nickpascucci/Robot-Arm/mechanical/AX_12_Drawing.jpg

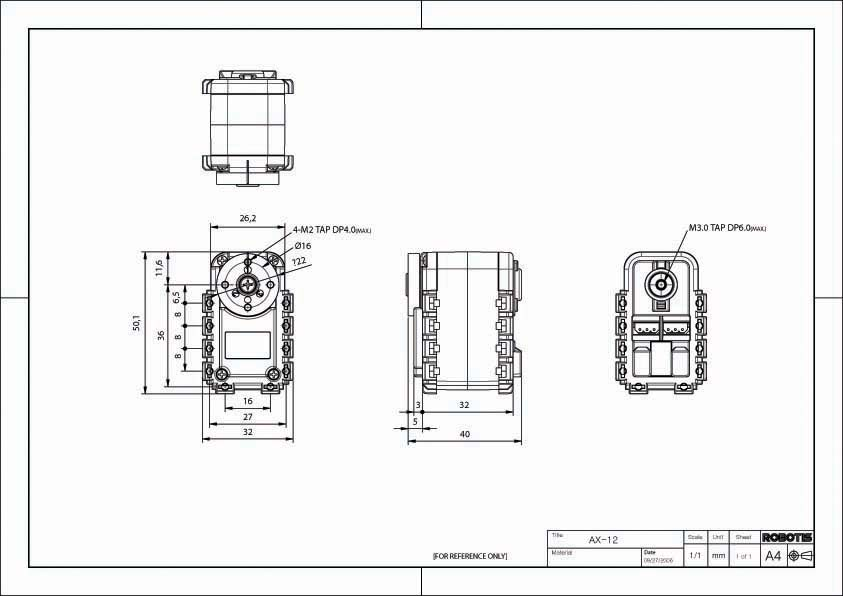
mechanical/AX_12_Drawing.jpg
