nickpascucci/Robot-Arm/mechanical/Costs.ods

Robot Arm Costs
Component | Unit Cost | Quantity | Total | Grand Total
1' 1.125” Delrin Rod | $30.14 | 2 | $60.28 | $690.88
1.5 | $26.93 | 2 | $53.86
AX-12 | $44.90 | 3 | $134.70
Hitec HS-485HB Standard Servo | $19.99 | 3 | $59.97
24” x 24” x .04” Aluminum Sheet | $36.64 | 2 | $73.28
Electronics | $200.00 | 1 | $200.00
Ball Bearing | $8.79 | 1 | $8.79
Spare Parts / Unforeseen Circumstances | $100.00 | 1 | $100.00
