nickpascucci/Robot-Arm/mechanical/EP_Proximal.dxf

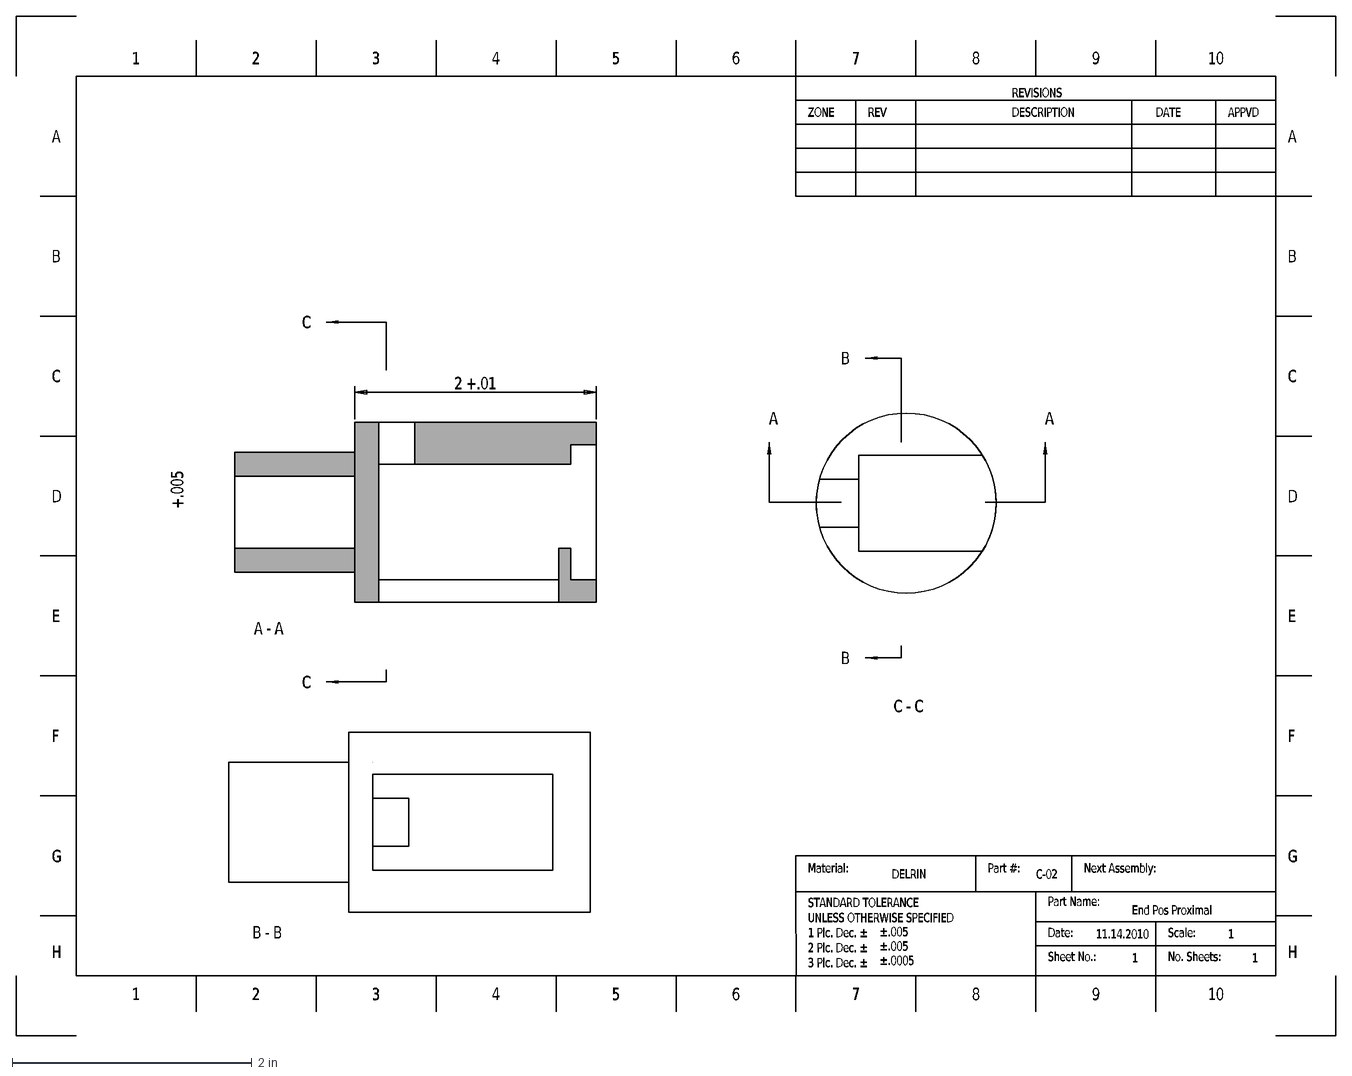
[picture p2: CAD file, 2011-05-08]
mechanical/EP_Proximal.dxf
1
2
3
4
5
6
7
8
9
10
A
B
C
D
E
F
G
H
STANDARD\~TOLERANCE UNLESS\~OTHERWISE\~SPECIFIED 1\~Plc.\~Dec.\~±\~ 2\~Plc.\~Dec.\~±\~ 3\~Plc.\~Dec.\~±
Material:
Part\~#:
Next\~Assembly:
Part\~Name:
Date:
Scale:
Sheet\~No.:
No.\~Sheets:
REVISIONS
ZONE
REV
DESCRIPTION
DATE
APPVD
DELRIN
C-02
±.005
±.0005
11.14.2010
End\~Pos\~Proximal
+.005
2\~+.01
A\~-\~A
B\~-\~B
C\~-\~C
