nickpascucci/Robot-Arm/mechanical/EP_Mid_Distal.dxf

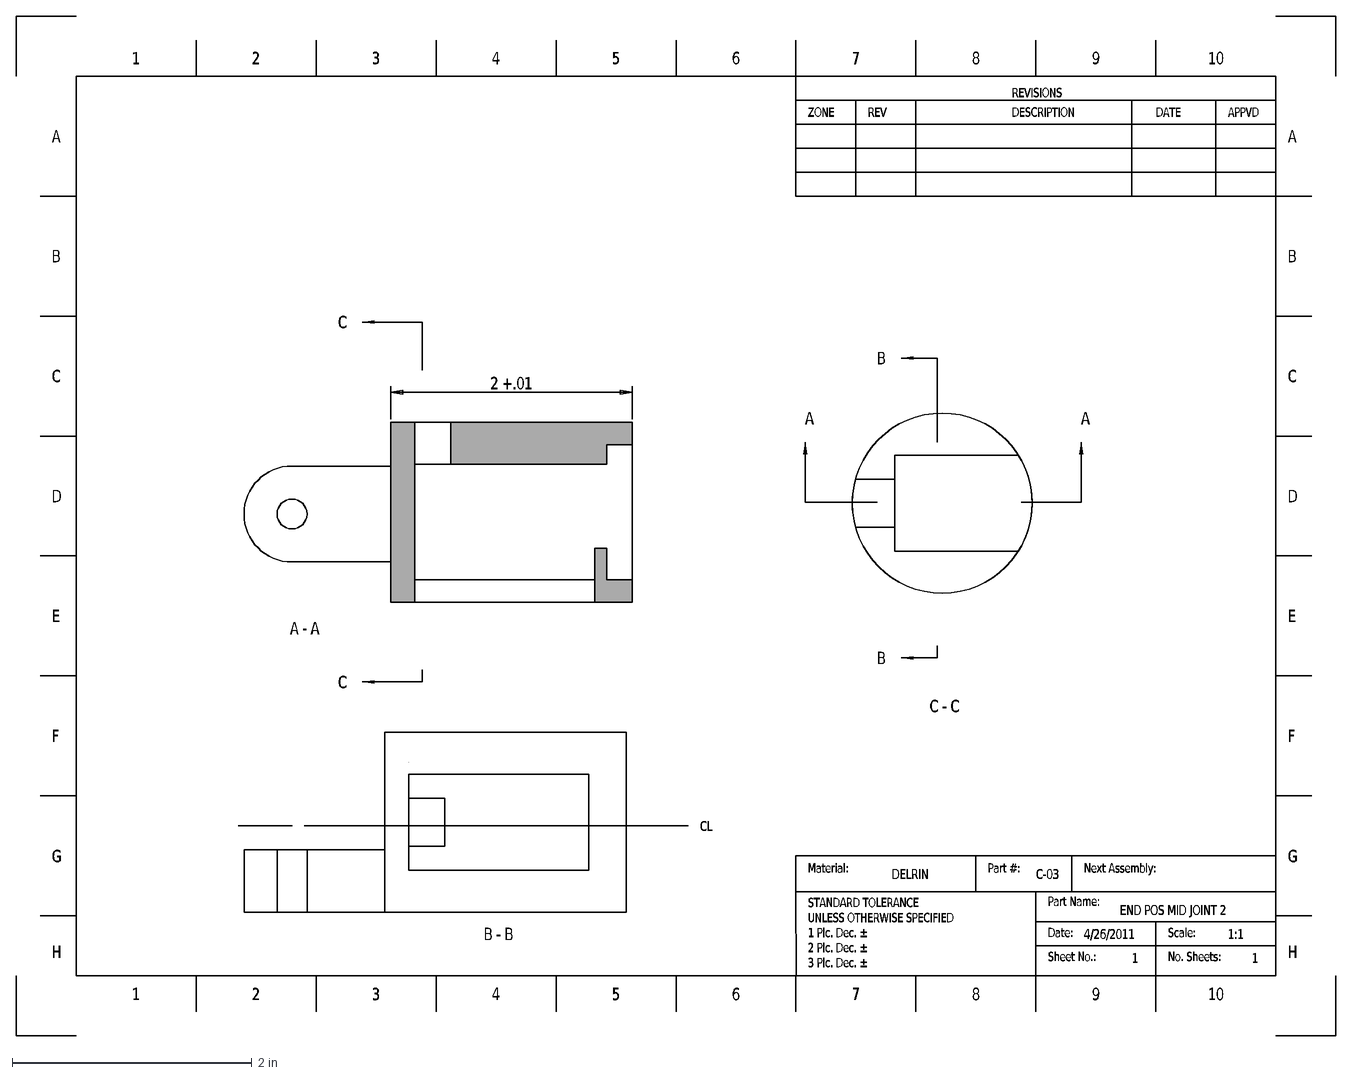
[picture p3: CAD file, 2011-05-08]
mechanical/EP_Mid_Distal.dxf
1
2
3
4
5
6
7
8
9
10
A
B
C
D
E
F
G
H
STANDARD\~TOLERANCE UNLESS\~OTHERWISE\~SPECIFIED 1\~Plc.\~Dec.\~±\~ 2\~Plc.\~Dec.\~±\~ 3\~Plc.\~Dec.\~±
Material:
Part\~#:
Next\~Assembly:
Part\~Name:
Date:
Scale:
Sheet\~No.:
No.\~Sheets:
REVISIONS
ZONE
REV
DESCRIPTION
DATE
APPVD
DELRIN
C-03
END\~POS\~MID\~JOINT\~2
1:1
4/26/2011
2\~+.01
C\~-\~C
B\~-\~B
A\~-\~A
CL
