nickpascucci/Robot-Arm/mechanical/EP_Mid_Proximal.dxf

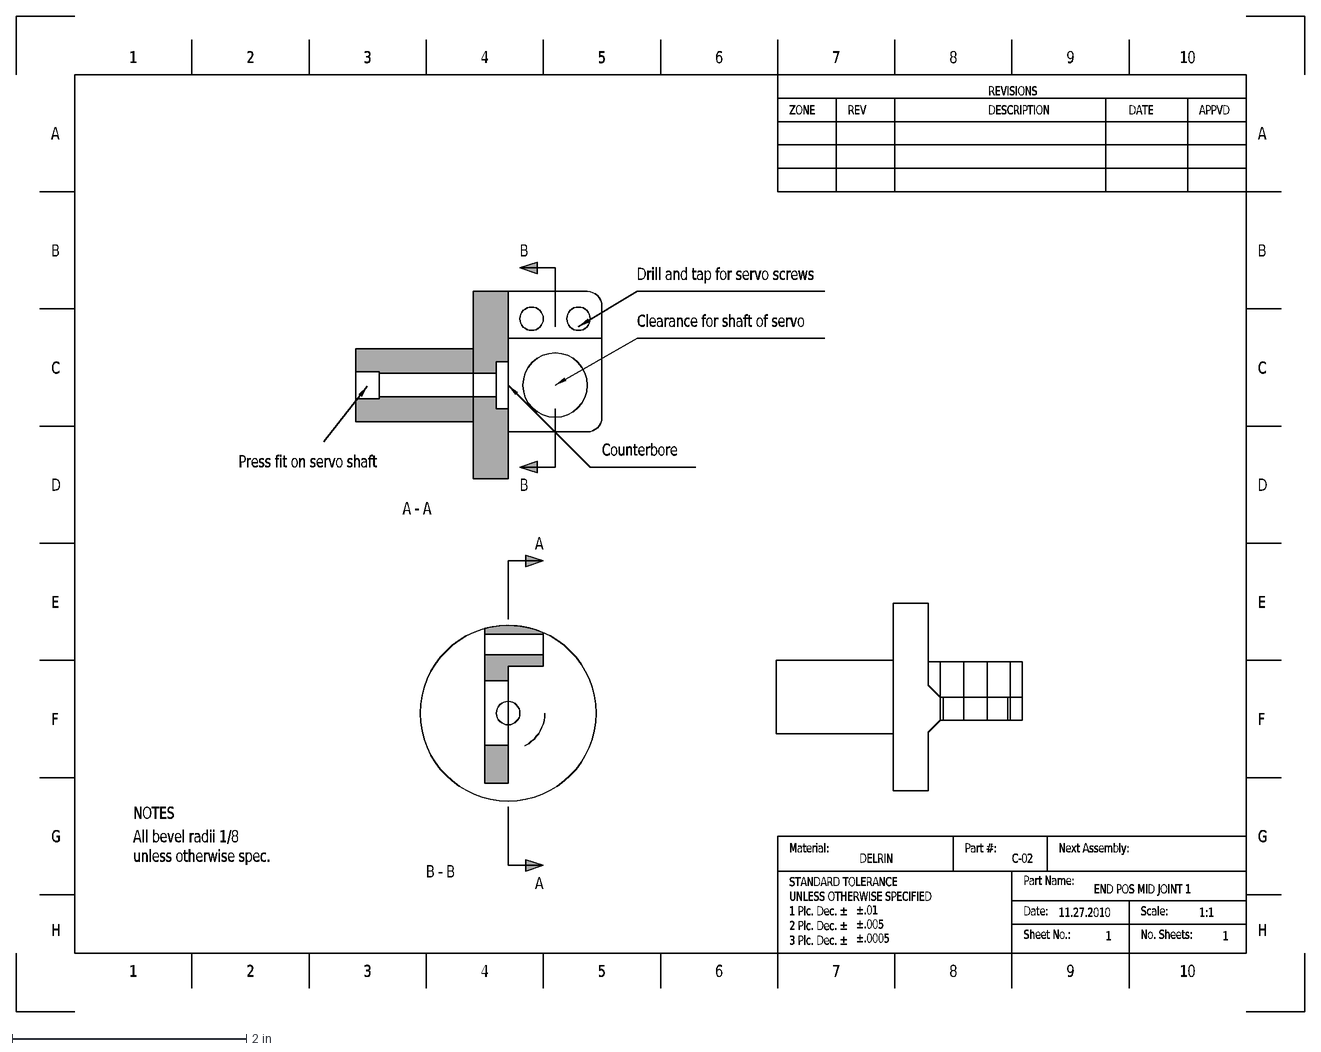
[picture p4: CAD file, 2011-05-08]
mechanical/EP_Mid_Proximal.dxf
Press\~fit\~on\~servo\~shaft
Drill\~and\~tap\~for\~servo\~screws
B
A
A\~-\~A
B\~-\~B
END\~POS\~MID\~JOINT\~1
DELRIN
C-02
11.27.2010
1
1:1
NOTES
All\~bevel\~radii\~1/8 unless\~otherwise\~spec.
Clearance\~for\~shaft\~of\~servo
±.01
±.005
±.0005
2
3
4
5
6
7
8
9
10
C
D
E
F
G
H
STANDARD\~TOLERANCE UNLESS\~OTHERWISE\~SPECIFIED 1\~Plc.\~Dec.\~±\~ 2\~Plc.\~Dec.\~±\~ 3\~Plc.\~Dec.\~±
Material:
Part\~#:
Next\~Assembly:
Part\~Name:
Date:
Scale:
Sheet\~No.:
No.\~Sheets:
REVISIONS
ZONE
REV
DESCRIPTION
DATE
APPVD
Counterbore
