nickpascucci/Robot-Arm/mechanical/Base_Servo_Mount.dxf

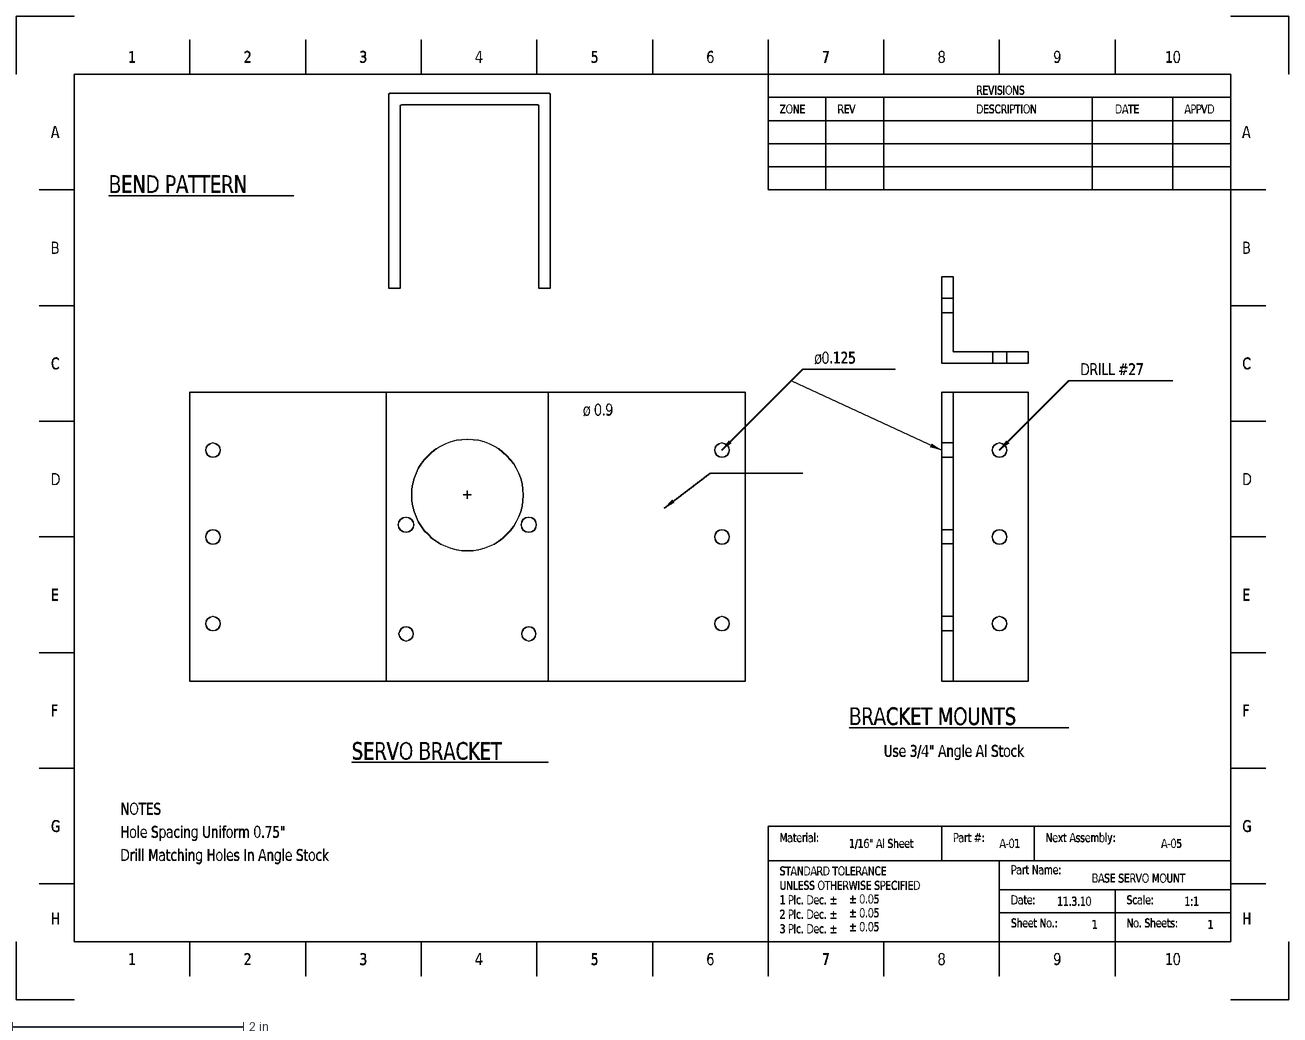
[picture p5: CAD file, 2011-04-27]
mechanical/Base_Servo_Mount.dxf
1
2
3
4
5
6
7
8
9
10
A
B
C
D
E
F
G
H
STANDARD\~TOLERANCE UNLESS\~OTHERWISE\~SPECIFIED 1\~Plc.\~Dec.\~±\~ 2\~Plc.\~Dec.\~±\~ 3\~Plc.\~Dec.\~±
Material:
Part\~#:
Next\~Assembly:
Part\~Name:
Date:
Scale:
Sheet\~No.:
No.\~Sheets:
REVISIONS
ZONE
REV
DESCRIPTION
DATE
APPVD
BASE\~SERVO\~MOUNT
A-05
A-01
1/16"\~Al\~Sheet
11.3.10
1:1
±\~0.05
ø\~0.9
Use\~3/4"\~Angle\~Al\~Stock
Drill\~Matching\~Holes\~In\~Angle\~Stock
Hole\~Spacing\~Uniform\~0.75"
NOTES
ø0.125
DRILL\~#27
SERVO\~BRACKET
BEND\~PATTERN
BRACKET\~MOUNTS
