nickpascucci/Robot-Arm/mechanical/ArmMounts.dxf

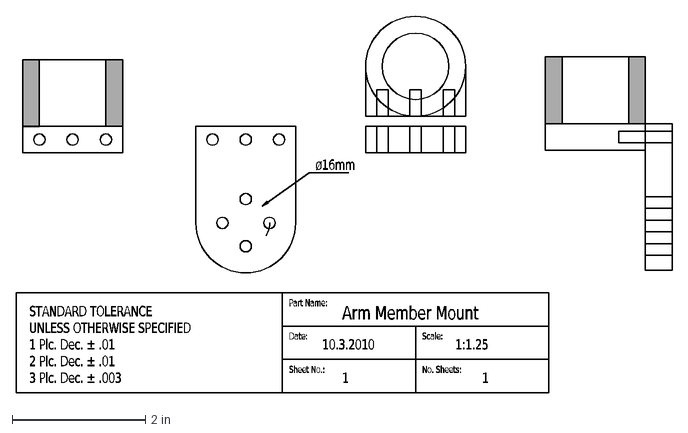
[picture p6: CAD file, 2011-04-27]
mechanical/ArmMounts.dxf
STANDARD\~TOLERANCE UNLESS\~OTHERWISE\~SPECIFIED 1\~Plc.\~Dec.\~±\~.01 2\~Plc.\~Dec.\~±\~.01 3\~Plc.\~Dec.\~±\~.003
Part\~Name:
Date:
Sheet\~No.:
Scale:
No.\~Sheets:
1
10.3.2010
Arm\~Member\~Mount
ø16mm
1:1.25
