nickpascucci/Robot-Arm/mechanical/Rotation_Reference.dxf

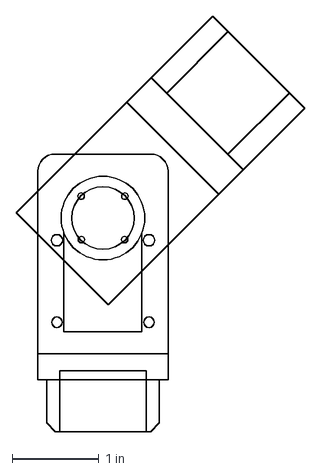
[picture p7: CAD file, 2011-04-27]
mechanical/Rotation_Reference.dxf
3.32 x 4.79 in
