nickpascucci/Robot-Arm/mechanical/Wrist.dxf

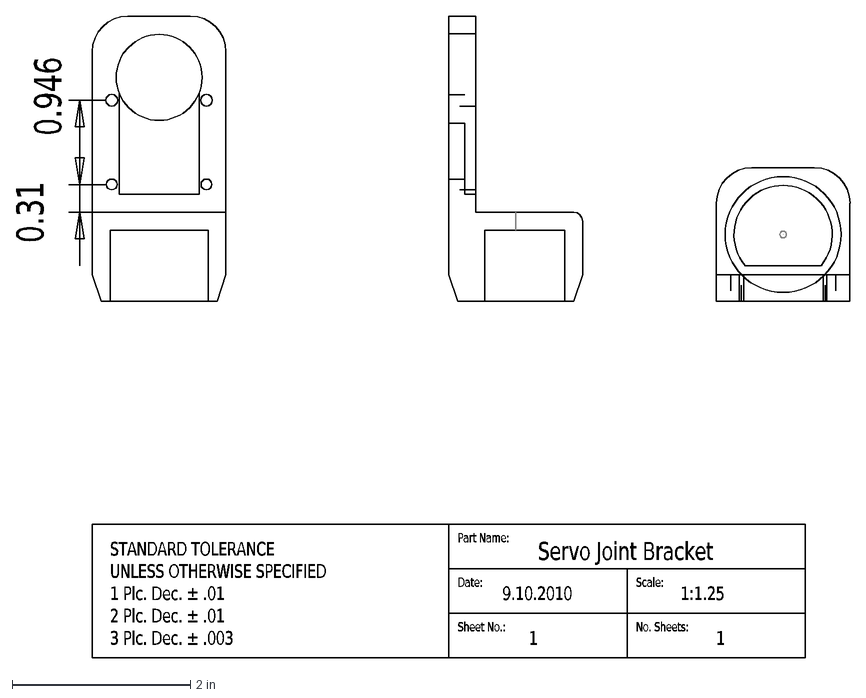
[picture p8: CAD file, 2011-04-27]
mechanical/Wrist.dxf
STANDARD\~TOLERANCE UNLESS\~OTHERWISE\~SPECIFIED 1\~Plc.\~Dec.\~±\~.01 2\~Plc.\~Dec.\~±\~.01 3\~Plc.\~Dec.\~±\~.003
Part\~Name:
Date:
Sheet\~No.:
Scale:
No.\~Sheets:
Servo\~Joint\~Bracket
9.10.2010
1
1:1.25
0.31
0.946
