nickpascucci/Robot-Arm/mechanical/Proximal_Mount.dxf

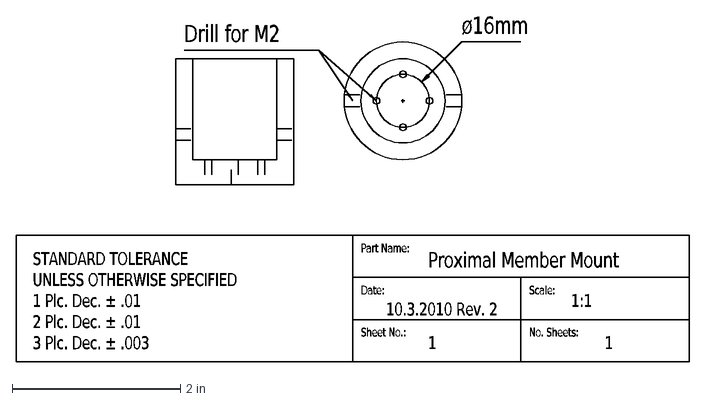
[picture p9: CAD file, 2011-04-27]
mechanical/Proximal_Mount.dxf
ø16mm
Drill\~for\~M2
STANDARD\~TOLERANCE UNLESS\~OTHERWISE\~SPECIFIED 1\~Plc.\~Dec.\~±\~.01 2\~Plc.\~Dec.\~±\~.01 3\~Plc.\~Dec.\~±\~.003
Part\~Name:
Date:
Sheet\~No.:
Scale:
No.\~Sheets:
1
1:1
Proximal\~Member\~Mount
10.3.2010\~Rev.\~2
