nickpascucci/Robot-Arm/mechanical/STD_Servo_Side.dxf

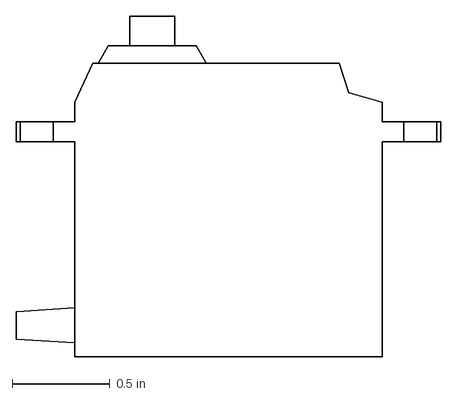
[picture p10: CAD file, 2011-04-27]
mechanical/STD_Servo_Side.dxf
2.17 x 1.74 in
