nickpascucci/Robot-Arm/mechanical/Bearing_Clamp.dxf

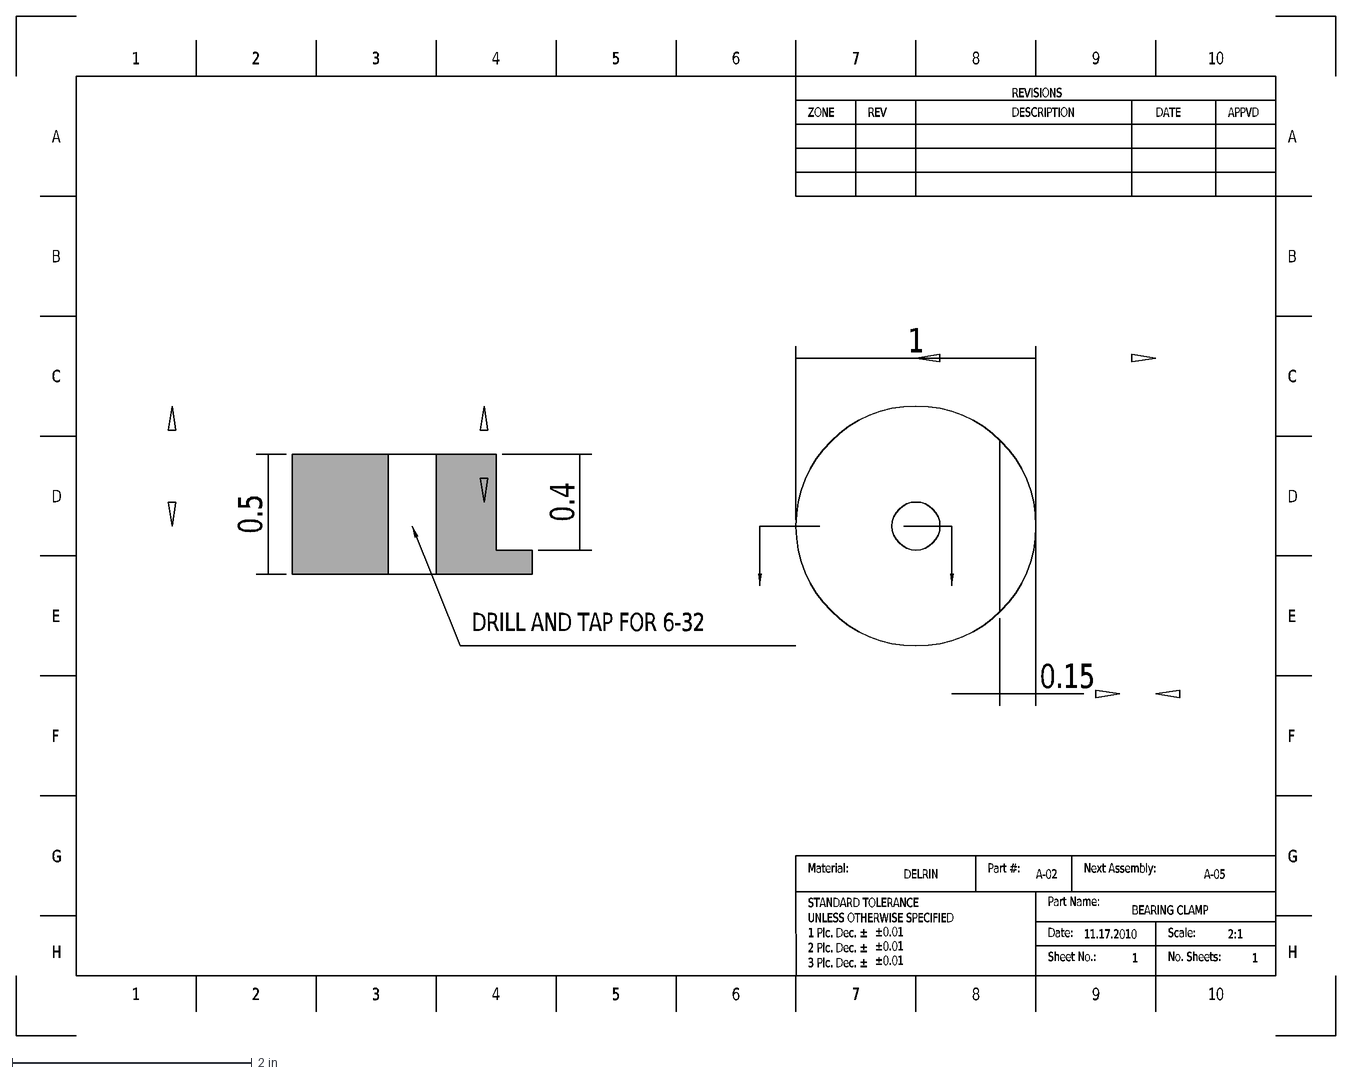
[picture p11: CAD file, 2011-04-27]
mechanical/Bearing_Clamp.dxf
1
2
3
4
5
6
7
8
9
10
A
B
C
D
E
F
G
H
STANDARD\~TOLERANCE UNLESS\~OTHERWISE\~SPECIFIED 1\~Plc.\~Dec.\~±\~ 2\~Plc.\~Dec.\~±\~ 3\~Plc.\~Dec.\~±
Material:
Part\~#:
Next\~Assembly:
Part\~Name:
Date:
Scale:
Sheet\~No.:
No.\~Sheets:
REVISIONS
ZONE
REV
DESCRIPTION
DATE
APPVD
BEARING\~CLAMP
A-02
A-05
DELRIN
11.17.2010
2:1
±0.01
0.4
0.5
0.15
DRILL\~AND\~TAP\~FOR\~6-32
