nickpascucci/Robot-Arm/mechanical/Connecting_Tube.dxf

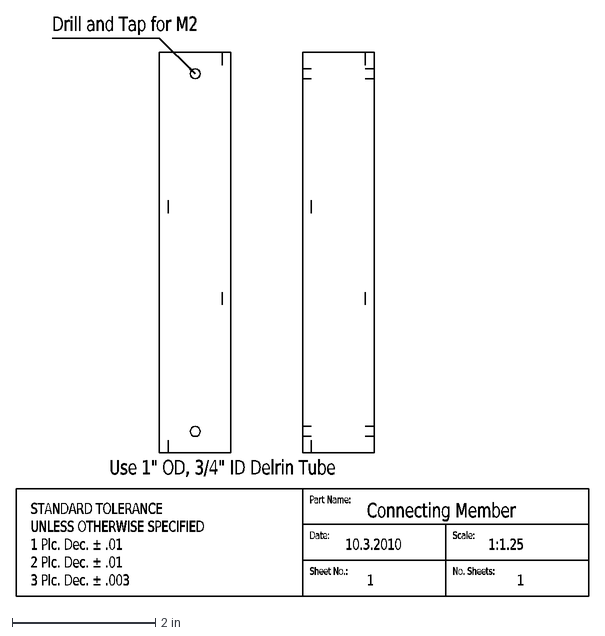
[picture p12: CAD file, 2011-04-27]
mechanical/Connecting_Tube.dxf
Drill\~and\~Tap\~for\~M2
STANDARD\~TOLERANCE UNLESS\~OTHERWISE\~SPECIFIED 1\~Plc.\~Dec.\~±\~.01 2\~Plc.\~Dec.\~±\~.01 3\~Plc.\~Dec.\~±\~.003
Part\~Name:
Date:
Sheet\~No.:
Scale:
No.\~Sheets:
1
1:1.25
Connecting\~Member
10.3.2010
Use\~1"\~OD,\~3/4"\~ID\~Delrin\~Tube
