nickpascucci/Robot-Arm/mechanical/STD_Servo_Front.dxf

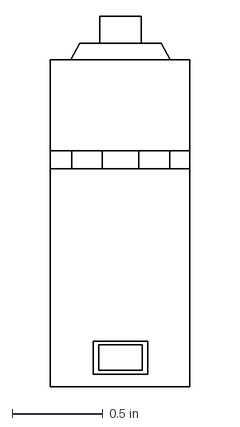
[picture p13: CAD file, 2011-04-27]
mechanical/STD_Servo_Front.dxf
0.77 x 2.04 in
