nickpascucci/Robot-Arm/mechanical/ServoMounts.dxf

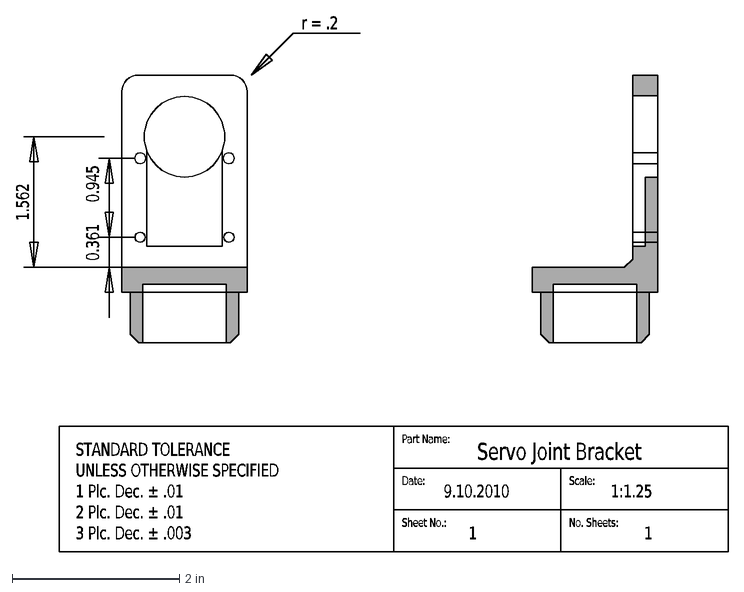
[picture p14: CAD file, 2011-04-27]
mechanical/ServoMounts.dxf
STANDARD\~TOLERANCE UNLESS\~OTHERWISE\~SPECIFIED 1\~Plc.\~Dec.\~±\~.01 2\~Plc.\~Dec.\~±\~.01 3\~Plc.\~Dec.\~±\~.003
Part\~Name:
Date:
Sheet\~No.:
Scale:
No.\~Sheets:
Servo\~Joint\~Bracket
9.10.2010
1
1:1.25
1.562
0.945
0.361
r\~=\~.2
