nickpascucci/Robot-Arm/mechanical/Base.dxf

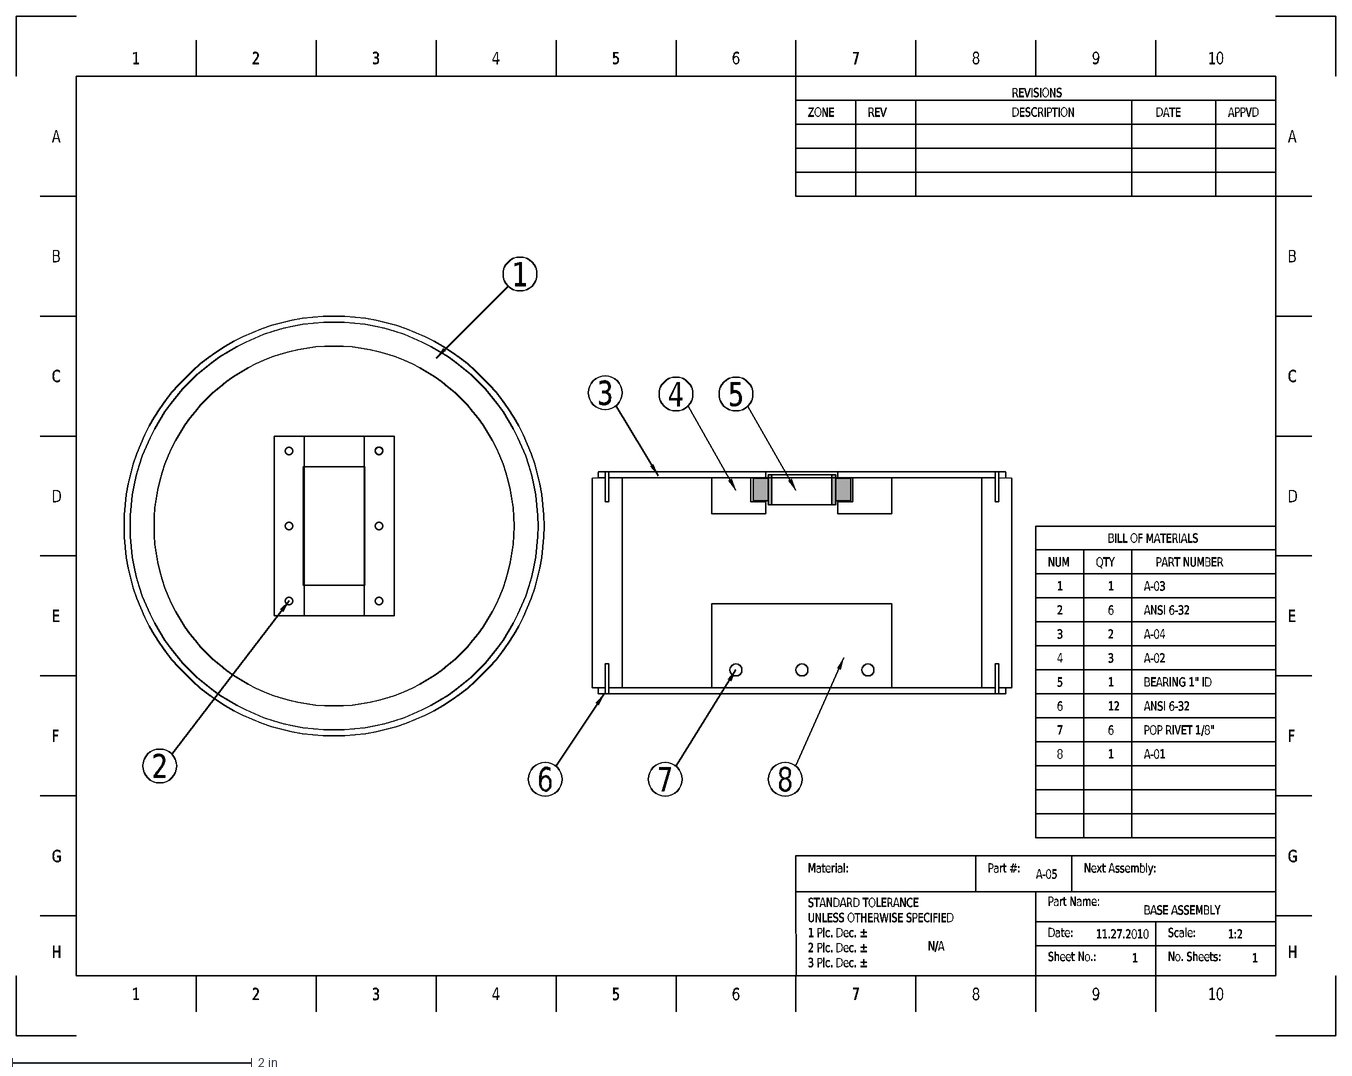
[picture p15: CAD file, 2011-04-27]
mechanical/Base.dxf
1
2
3
4
5
6
7
8
9
10
A
B
C
D
E
F
G
H
STANDARD\~TOLERANCE UNLESS\~OTHERWISE\~SPECIFIED 1\~Plc.\~Dec.\~±\~ 2\~Plc.\~Dec.\~±\~ 3\~Plc.\~Dec.\~±
Material:
Part\~#:
Next\~Assembly:
Part\~Name:
Date:
Scale:
Sheet\~No.:
No.\~Sheets:
REVISIONS
ZONE
REV
DESCRIPTION
DATE
APPVD
A-05
BASE\~ASSEMBLY
11.27.2010
1:2
N/A
NUM
QTY
BILL\~OF\~MATERIALS
PART\~NUMBER
POP\~RIVET\~1/8"
BEARING\~1"\~ID
ANSI\~6-32
12
A-02
A-01
A-03
A-04
