nickpascucci/Robot-Arm/(list of files, cad)

Other CAD files:
mechanical/Arm_Mounts.dxf
mechanical/Servo_Mounts.dxf
