nickpascucci/Robot-Arm/electronics/mainboard.brd

## EAGLE design electronics/mainboard.brd (2012-05-15)

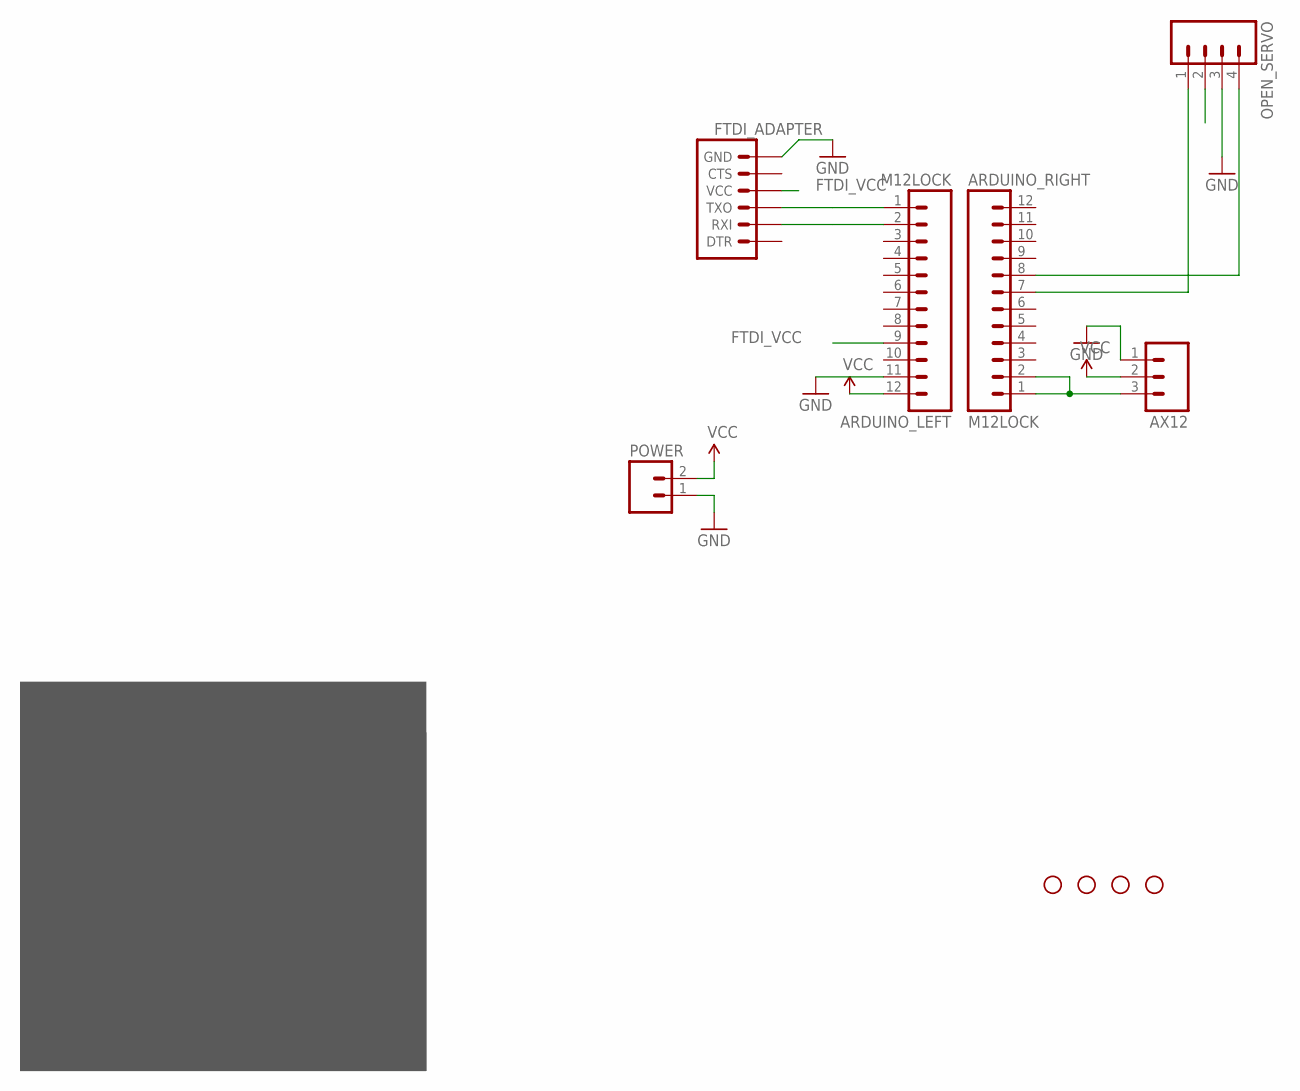
[picture p16: schematic mainboard.sch]

Parts:
ARDUINO_LEFT: M12LOCK; 1X12_LOCK
ARDUINO_RIGHT: M12LOCK; 1X12_LOCK
AX12: M03LOCK; 1X03_LOCK
FTDI_ADAPTER: ARDUINO_SERIAL_PROGRAMLOCK; 1X06_LOCK
JP1, JP2, JP3, JP4: STAND-OFF
OPEN_SERVO: M04LOCK; 1X04_LOCK
POWER: M023.5MM; SCREWTERMINAL-3.5MM-2

Connections:
AX_DATA: ARDUINO_RIGHT.1, ARDUINO_RIGHT.2, AX12.3
FTDI_RX: ARDUINO_LEFT.2, FTDI_ADAPTER.2 (RXI)
FTDI_TX: ARDUINO_LEFT.1, FTDI_ADAPTER.3 (TXO)
FTDI_VCC: ARDUINO_LEFT.9, FTDI_ADAPTER.4 (VCC)
GND: ARDUINO_LEFT.11, AX12.1, FTDI_ADAPTER.6 (GND), OPEN_SERVO.3, POWER.1
unnamed: ARDUINO_RIGHT.7, OPEN_SERVO.1
unnamed: ARDUINO_RIGHT.8, OPEN_SERVO.4
VCC: ARDUINO_LEFT.12, AX12.2, POWER.2

Notes on the sheet:
8 Pin Header, Pol
Parts List
Part Name
Component
ATX_ADAPTER
AX12
V_REG_317
74HC4052
FTDI_ADAPTER
ARDUINO_LEFT
ARDUINO_RIGHT
12 Pin Header, Fem
3 Pin Header
6 Pin Header, Pol
LM317 Adj Volt Reg
74HC4052 Serial Mux
OPEN_SERVO
4 Pin Header, Pol
MBT2222ALT3G NPN
Q1, Q2
OPTOISOLATOR
ILD213T
All Resistors
0805 Surface Mount

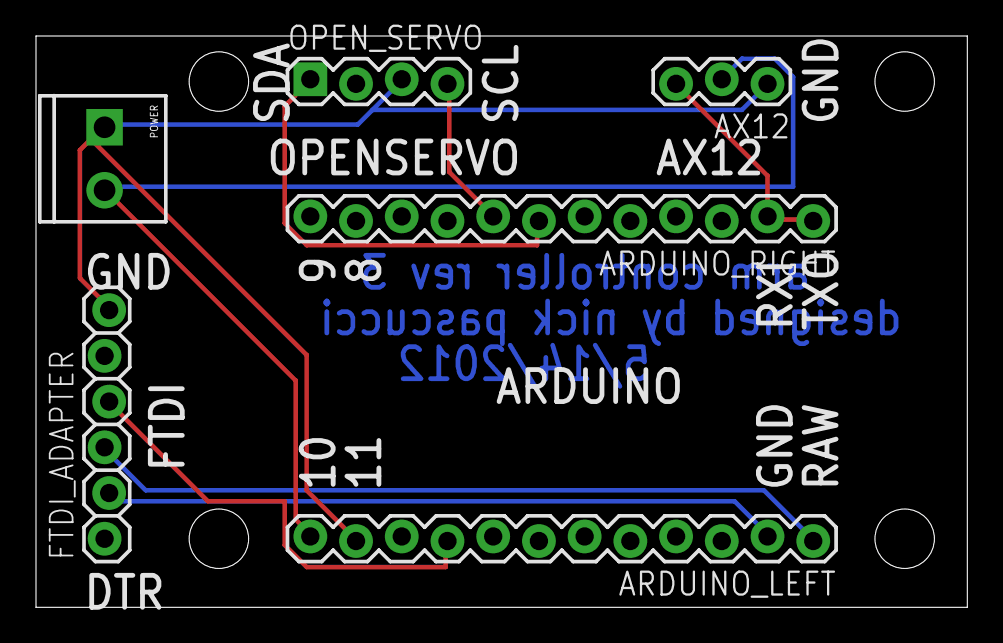
[picture p17: board mainboard.brd from above]

Board: 2 copper layers, 51.7 x 31.7 mm, 10 parts (0 on the bottom side), 8 nets.
