nickpascucci/Robot-Arm/(commit log)

2011-05-08 Added serial command support.
    [EP_Mid_Distal.dxf, EP_Mid_Proximal.dxf, EP_Proximal.dxf]
2011-05-09 Added serial command support to replace various helper functions.
    [ArmControl.pde]
2011-05-11 Fixed module names in InverseKinematics.
    [InverseKinematics.py]
2011-05-15 Fixed various bugs.
    The ground on the LED side of the optoisolator was incorrectly wired
    to FTDI ground for both pins; this was rectified.
    The board was resized to provide more room for wiring and easier
    soldering. I also added another mounting hole.
    Various changes made to software, such as the beginnings of a test
    routine in the firmware and adding GUI support for such.
    [mainboard.brd, mainboard.sch]
2012-05-15 Reduced main board complexity significantly.
    [mainboard.brd, mainboard.sch]
